kikifachrizi/Development_Food_Assistant_Robot/riset_base_3_revisi_update/rotaryencoder/README.md

# RotaryEncoder
Qudrature Rotary Encoder for DC Motor to measure position and speed in any STM32 Board with Mbed Frameworks. Works with mbed-os 5.
