kikifachrizi/Development_Food_Assistant_Robot/report_11_05_2024/Report T.I.F.A 06112024.pdf

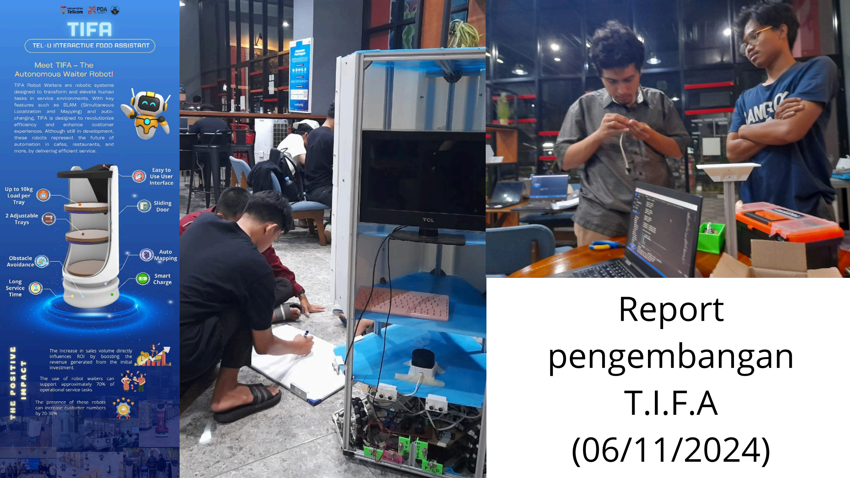
[picture p2: page 1]

## Report pengembangan T.I.F.A

(06/11/2024)

## Objective Pembahasan : 1.Proof of concept (done) 2.Proof of concept (process) 3.Result Progres 4.Program Matrikulasi Teknis

Update :
1.Robot System
Metode Kinematik and
Environment Learning

2.

3.Result proof of concept

Goal :
1.Obstacle Avoidance
2.Looks Robot
3.Lifetime robot
4.Mapping

Proof of Concept (done)
Serial communication
between Micro

1.

2.Mapping from Lidar
3.ERD database
4.Application interface

Proof of Concept (process) Printing Prototype robot
design 1:1 Scale

1.

Update Algorithm
Kinematics robot

2.

3.TF library & Kalman Filter robot baru mencapai 30% pengembangan berdasarkan semua metode yang sudah di coba (yang gagal dan berhasil)

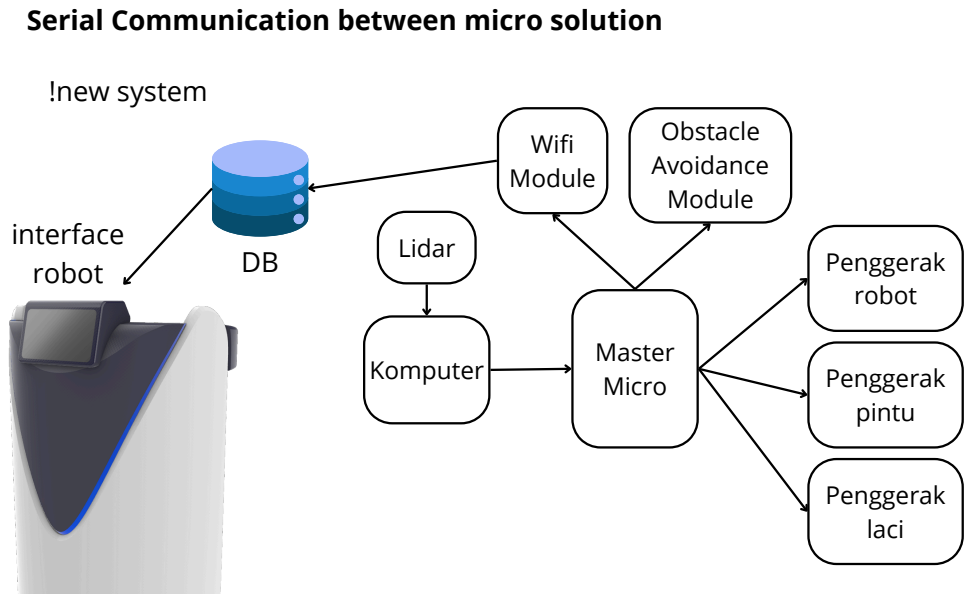
[picture p3: page 4]
Komputer; Master Micro; Lidar; Wifi Module; Obstacle Avoidance Module; Penggerak robot; Penggerak laci; Penggerak pintu; !new system; interface; robot

Serial Communication between micro solution

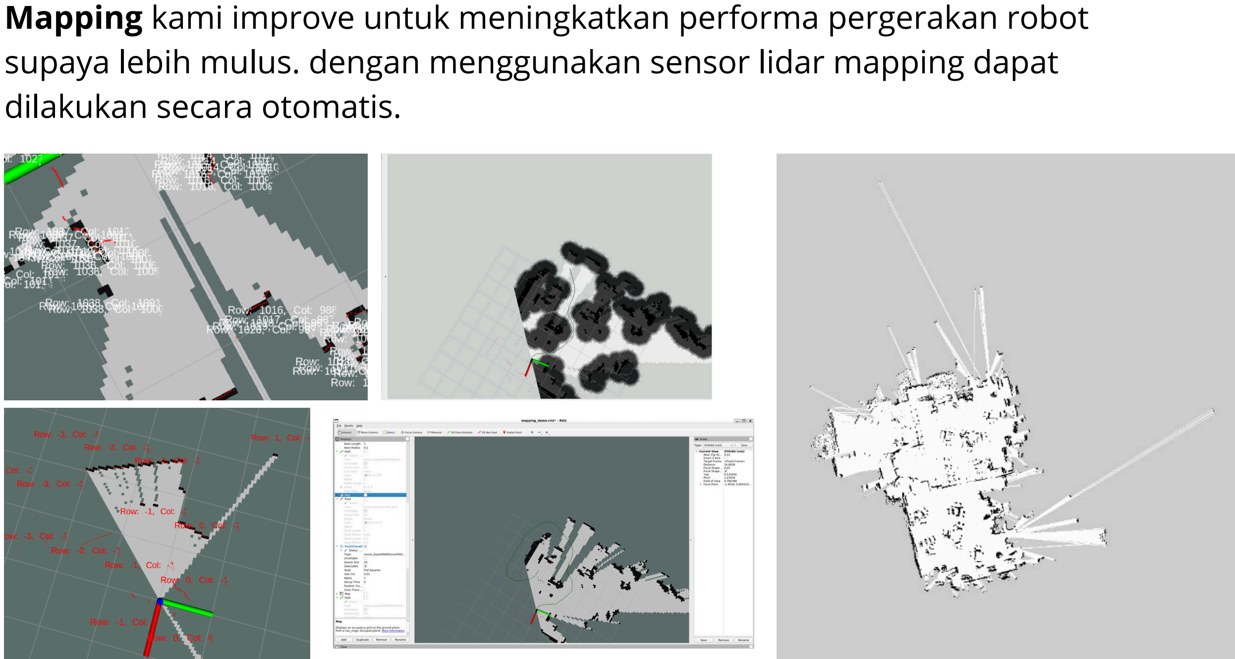
[picture p4: page 5]

Mapping kami improve untuk meningkatkan performa pergerakan robot supaya lebih mulus. dengan menggunakan sensor lidar mapping dapat dilakukan secara otomatis.

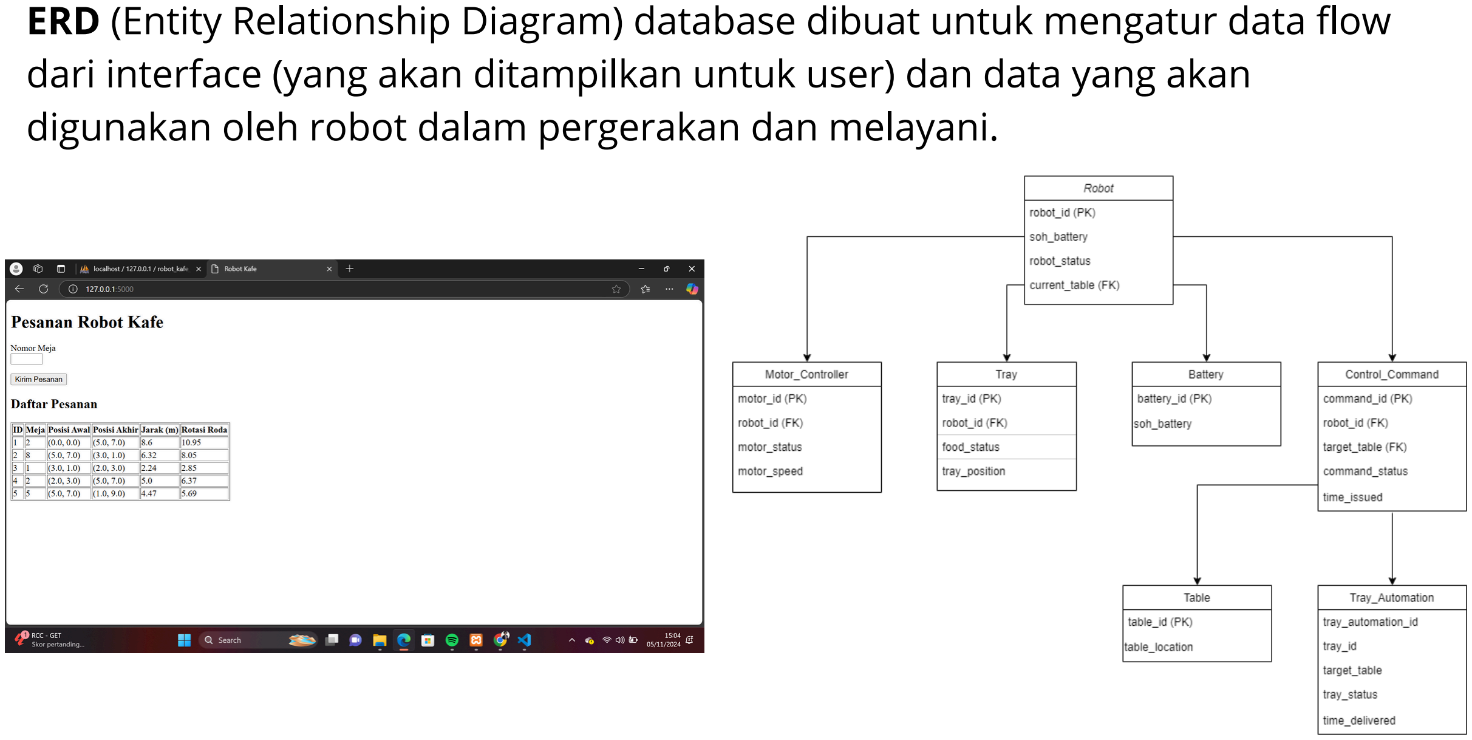
[picture p5: page 6]

ERD (Entity Relationship Diagram) database dibuat untuk mengatur data flow dari interface (yang akan ditampilkan untuk user) dan data yang akan digunakan oleh robot dalam pergerakan dan melayani.

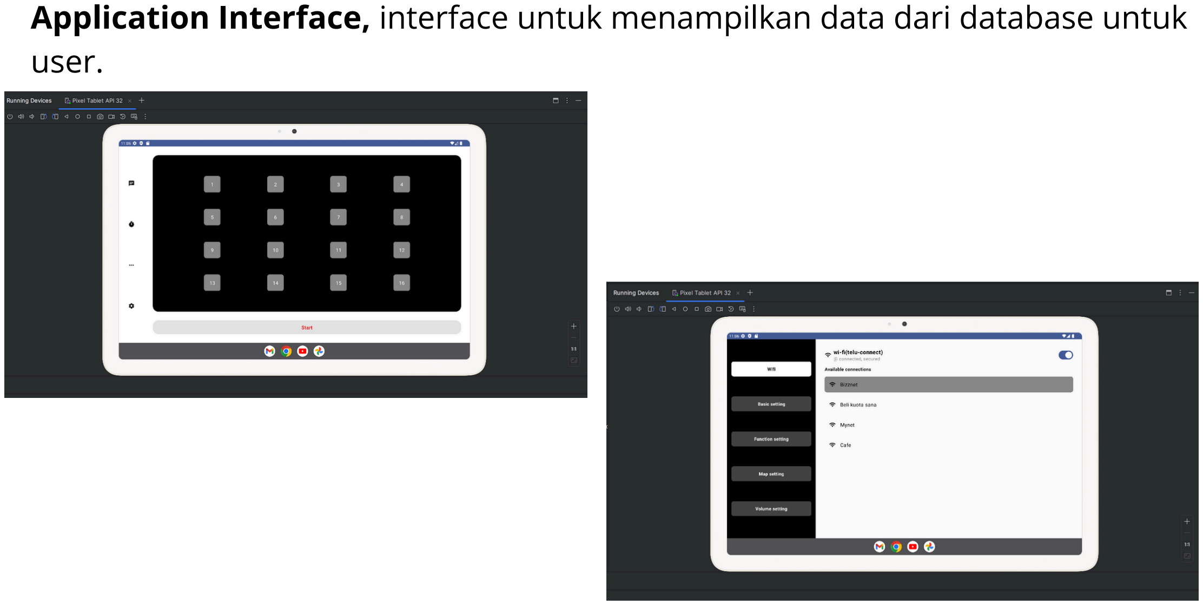
[picture p6: page 7]

Application Interface, interface untuk menampilkan data dari database untuk user.

Berikut beberapa proof of concept yang masih di tahap pengerjaan saat ini:

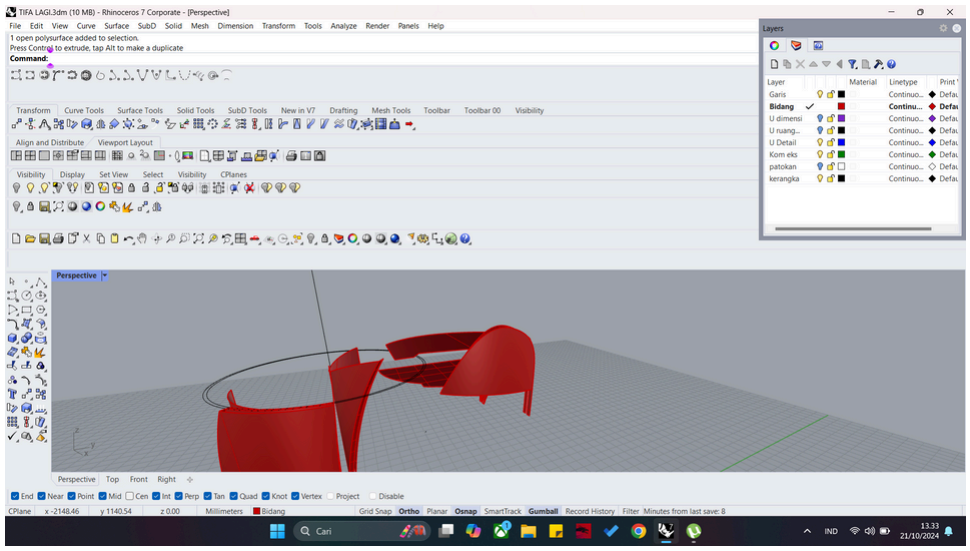
[picture p7: figure]
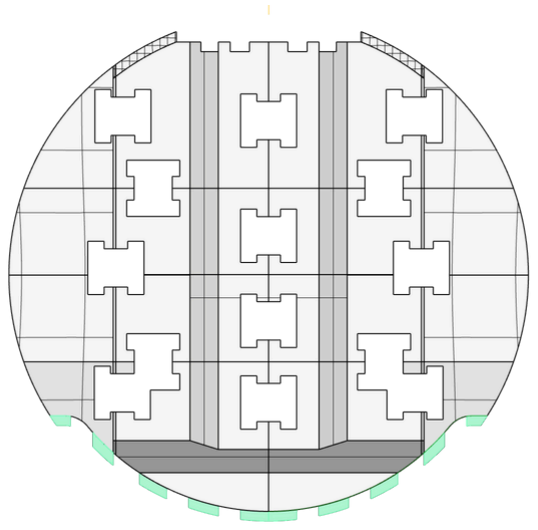
[picture p8: figure]
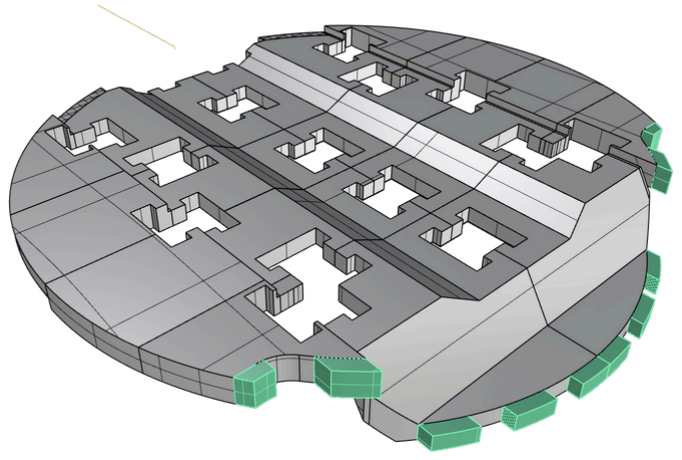
[picture p9: figure]

tahap ini kami membuat cetakan dengan mesin 3D print untuk manufaktur body robot, selain itu kami juga masih dalam tahap riset terkait kinematik dan filtering untuk motion robot.

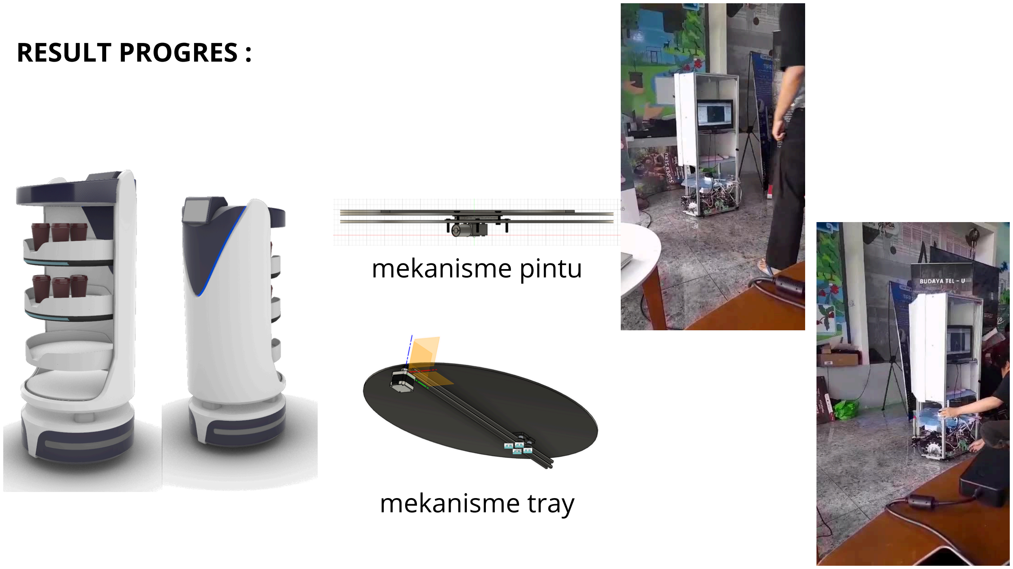
[picture p10: page 9]

RESULT PROGRES :

mekanisme pintu

mekanisme tray

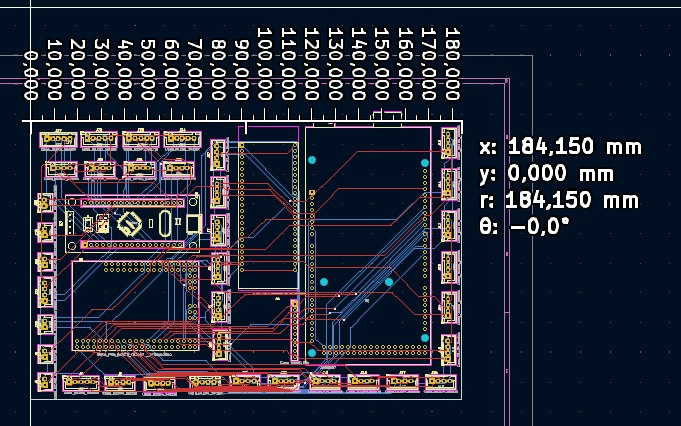
[picture p11: page 10]

Program Matrikulasi Teknis
Matrikulasi teknis kami berikan untuk pembekalan tim dalam pengerjaan robot, sehingga tim memiliki banyak waktu dalam melakukan riset hal baru. tim teknis tidak perlu melakukan riset yang sudah dilakukan karena semua itu akan di berikan di matrikulasi teknis oleh kami.

1.Kinematika dasar : robot 2 roda differential kinematik 2.Kontrol dasar : PID for mobile robot
3.Kinematika dan Kontrol

# List Sponsor

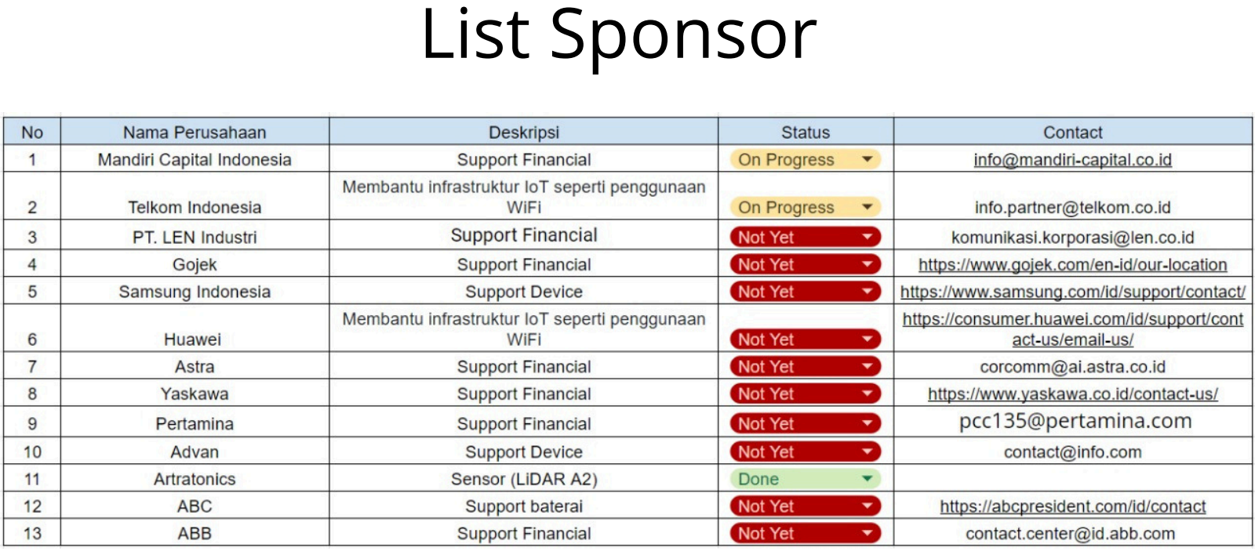
[picture p12: page 12]

# Terima Kasih🙏🙏🙏
