kikifachrizi/Development_Food_Assistant_Robot/documentation/IoT/RANGKUMAN SENSOR PROXIMITY SHARP A041SK.pdf

RANGKUMAN SENSOR PROXIMITY SHARP A041SK/GP2Y0A41SK0F
Berikut adalah perbandingan singkat dan jelas antara sensor Sharp GP2Y0A41SK dan load cell: Sensor Sharp GP2Y0A41SK

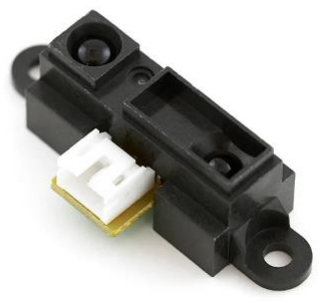
[picture p18: figure]
Kelebihan :

Sensitivitas Tinggi : Mendeteksi partikel debu kecil. Rata-rata digunakan untuk pemantauan kualitas udara, tapi bisa dipakai untuk mengukur jarak benda
Punya jarak yang bermacam macam sesuai kebutuhan
Gampang ditemuin : efisiensi tempat
Dari daya yang di lihat termasuk iot Daya Rendah : Hemat dan bisa digunakan jangka panjang alat berukuran kecil, mudah dipasang.

Sejauh aku liat risetnya :
- Pemantauan kualitas udara (paling banyak)
- Alat pembersih udara.
- Proyek IoT untuk lingkungan.
- IOT mengukur jarak benda

Beberapa video yang aku jadikan reference untuk sharp A041SK

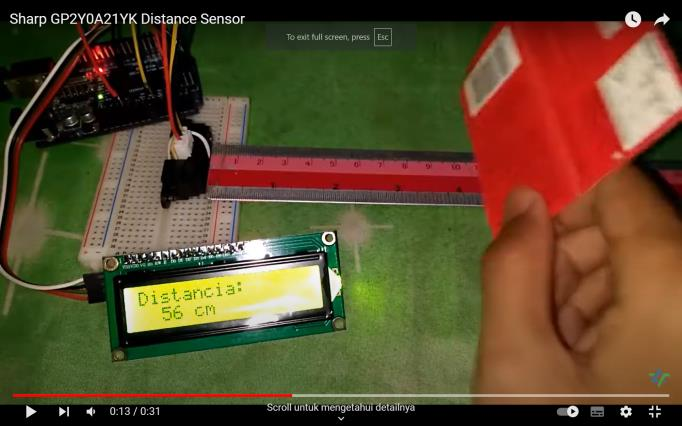
[picture p19: figure]
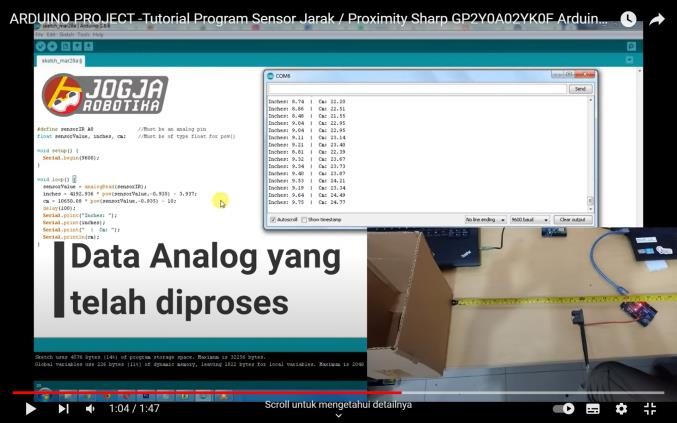
[picture p20: figure]
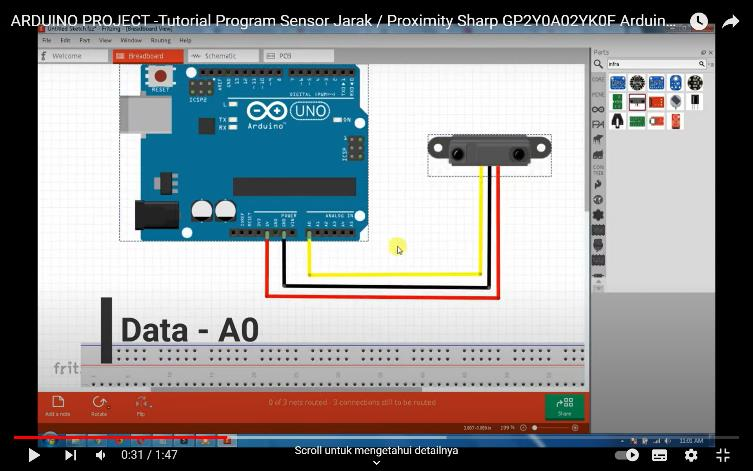
[picture p21: figure]
