kikifachrizi/Development_Food_Assistant_Robot/documentation/POWER/BMS Pemilihan Prototype.pdf

## BMS DESIGN

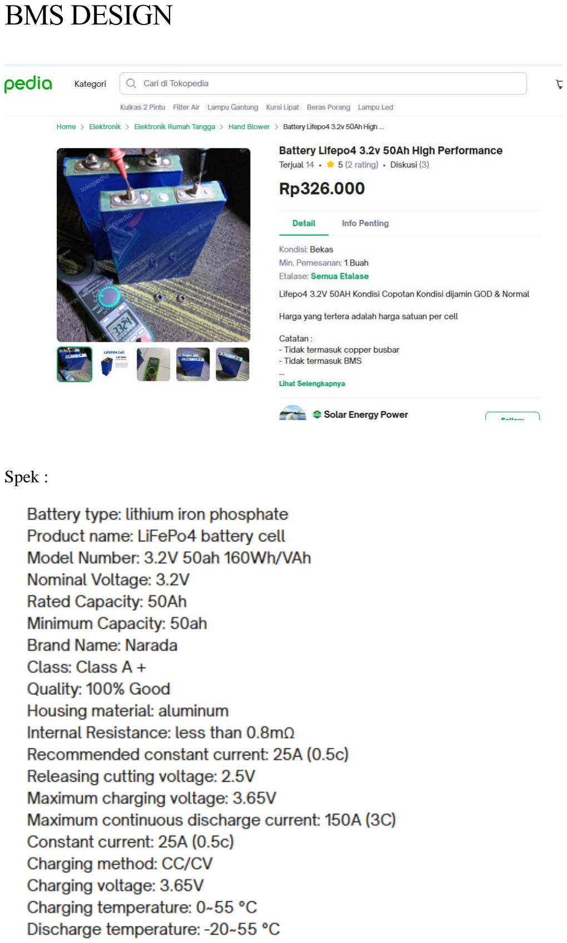
[picture p22: page 1]

Spek :

Jika Ingin 12 Jam Backup

BMS 4s = 12.8 V/50 ah = 640 Wh , Beban Max = 53 W

BMS 8s = 25.6 V/50 ah = 1,280 Wh, Beban Max = 106 W

BMS 16s = 51.2 V/50 ah = 2,560 Wh, Beban Max = 213 W

BMS Current = 25 A

BMS Prototype 2 Opsi :

1.Pakai IC Khusus BMS

IC dari Texas Instrument

IC BQ76952

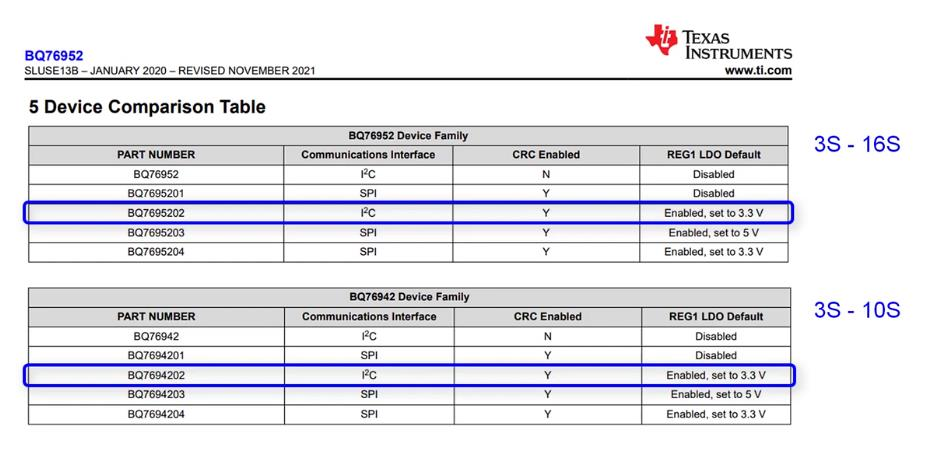
[picture p23: figure]

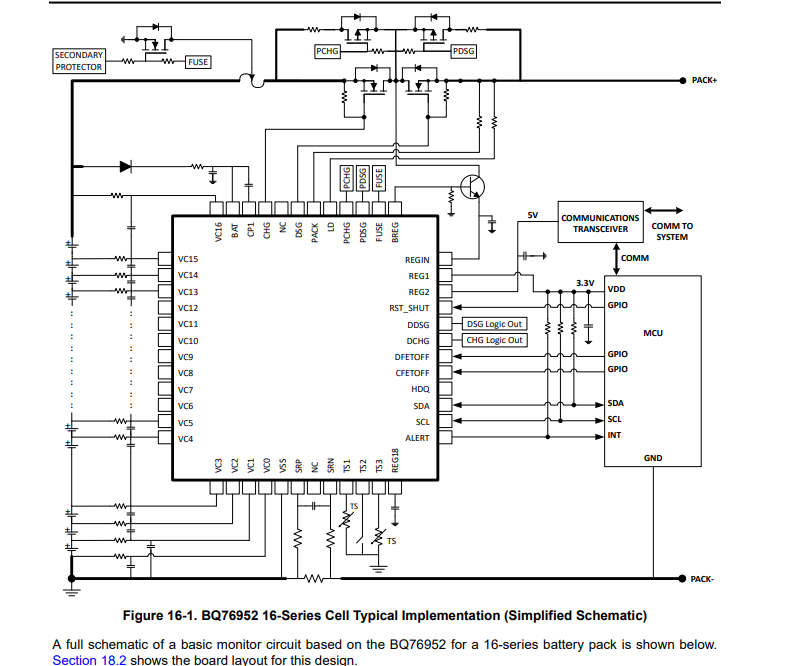
[picture p24: figure]

Pros:

-Up to 16S

-Dokumentasi Hardware dan Software Lengkap langsung dari official

Cons :

-IC dan Komponen pendukung lainnya relative sulit di jual belikan di Indonesia

2.Tidak Pakai IC

Contoh 7s

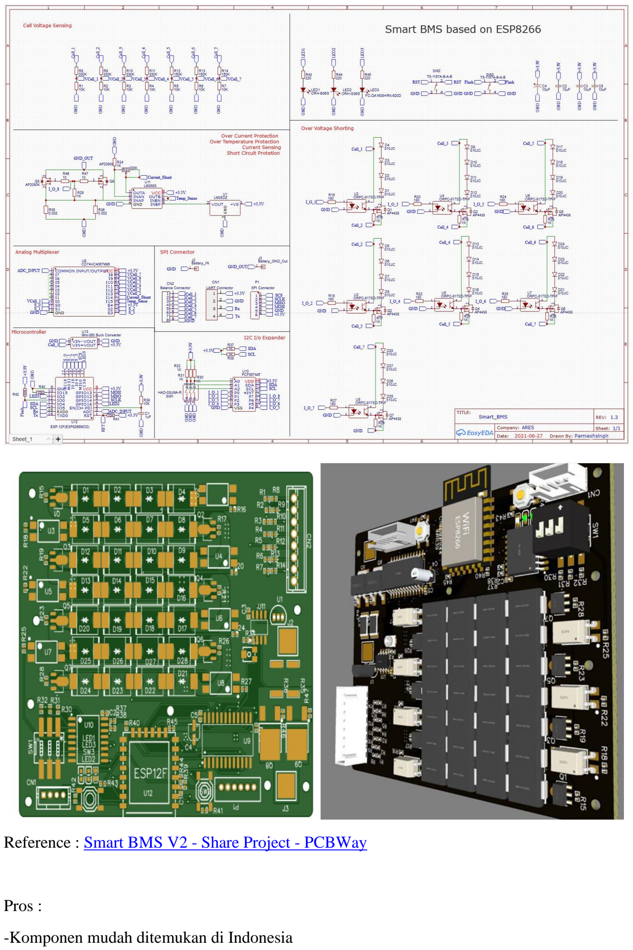
[picture p25: page 4]

Reference : Smart BMS V2 - Share Project - PCBWay (https://www.pcbway.com/project/shareproject/Smart_BMS_V2.html)

Pros :

-Komponen mudah ditemukan di Indonesia

Cons :

-Dokumentasi tidak Lengkap, perlu di pelajari lebih lanjut bagian software
