kikifachrizi/Development_Food_Assistant_Robot/documentation/POWER/Laporan Riset Awal Deli-Robot.pdf

### LAPORAN RISET DELI ROBOT TANGGAL : 06/09/2024

JENIS ROBOT YANG SUDAH ADA DAN POWER SYSTEM NYA

1. SIFROBOT

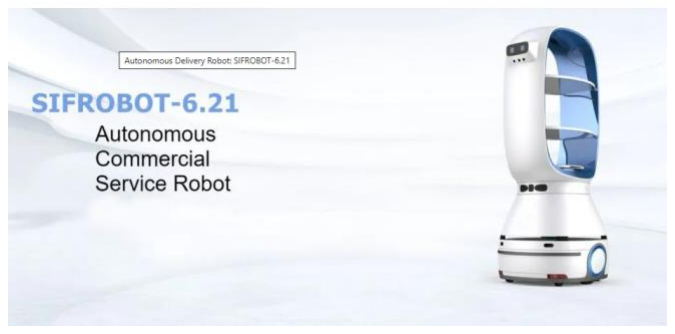
[picture p26: figure]

Di desain untuk kondisi COIVD-19, robot Indoor

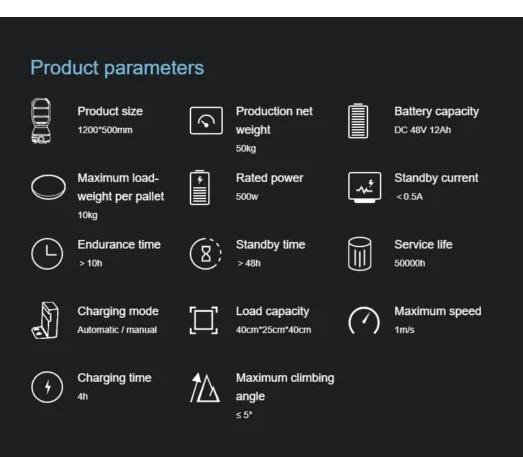
[picture p27: figure]

Spesifikasi utama :

Batterai Capacity : 48V/12 Ah

Arus StandBy : <0.5 A

Temp : 0 – 45 C

Daya :500 W

Durasi Battery : > 8 Jam

Referensi : Autonomous Delivery Robot: SIFROBOT-6.21 - SIFSOF (https://sifsof.com/product/autonomous-delivery-robot-sifrobot-6-21/)

2. DDY-4

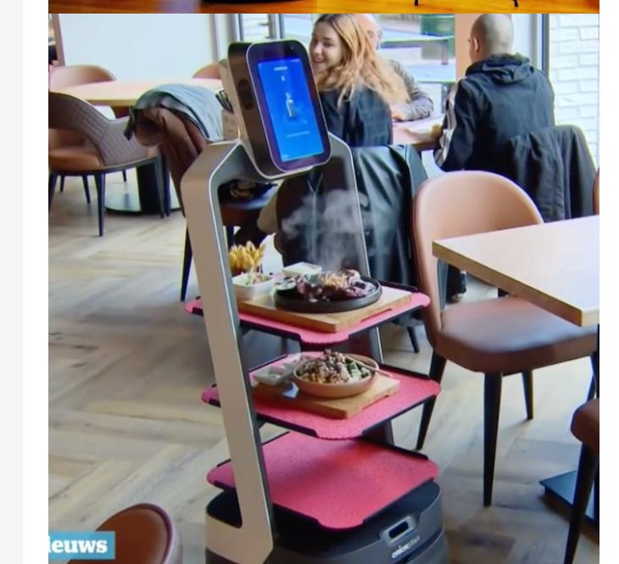
[picture p28: figure]

Spesifikasi utama :

Batterai Capacity : 48V/15 Ah

Arus StandBy : <0.5 A

Temp : 0 – 45 C

Daya :30 W

Durasi Battery : > 8 Jam

Referensi : Pelayan White Delivery Robot Food 12-14H Battery Life Steak Sushi Restaurant (services-robot.com) (https://indonesian.services-robot.com/sale-14495258-waiters-white-delivery-robot-food-12-14h-battery-life-steak-sushi-restaurant.html)

3. REEMAN – DELIGO

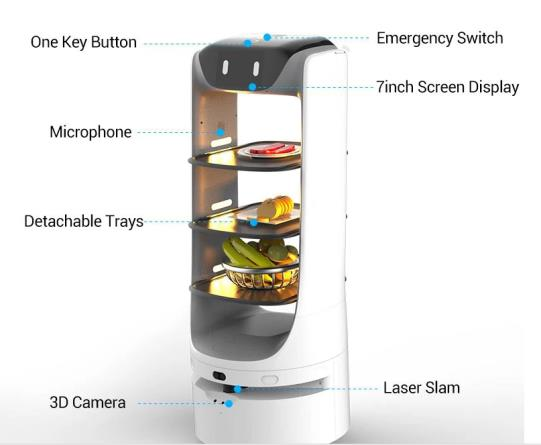
[picture p29: figure]

Spesifikasi utama :

Batterai Capacity : 24V/20 Ah

Temp : 0 – 45 C

Durasi Battery : 10-12 Jam

Referensi : Cina Disesuaikan Reeman Robot Pelayan Restoran Cepat Saji Pengiriman Robot Layanan Robot Pemasok, Produsen - Pabrik Grosir Langsung - REEMAN (https://id.reemanrobot.com/delivery-robot/restaurant-delivery-robot-service.html)

4.
Note : Tidak dapat ditemukan Detail dari jenis Battery yang digunakan, namun rata rata battery yang digunakan adalah Lithium

PERBEDAAN NMC DAN LIFEPO4, SERTA KEUNGGULANNYA

1. KOMPOSISI MATERIAL
NMC Menggunakan Nickel Manganese Cobalt Oxide LFP Menggunakan Lithium Ferrous Phosphate
2. ENERGY DENSITY
NMC = 150-200 Wh/KG
LFP = 100-150 Wh/KG
NMC Memiliki Kepadatan Energi yang lebih tinggi
3. CYCLE
NMC = 2000-2500
LFP = 5000
LFP Lebih tahan lama, memiliki 2x lipat Cycle dari NMC
4. SAFETY
NMC = Material Stabil, Namun komposisi dari material dapat menyebabkan Peledakan ataupun kebakaran jika terjadi kesalahan (Note : Material menghasilkan pelepasan Oksigen)

LFP = Material Stabil dan Dapat mengatasi Temperature yang tinggi(Note : Tidak menhasilkan Oksigen)

5. POWER
NMC = 3.7 V
LFP = 3.2 V

Referensi : Lithium NMC vs LiFePO4 - How to Choose the Best One for Your Needs (ecotreelithium.co.uk) (https://ecotreelithium.co.uk/news/lithium-nmc-vs-lifepo4/)

Kesimpulan , menurut saya sebagai kebutuhan power dari Deli-Robot, LFP atau LIFEPO4 lebih cocok digunakan. Mempertimbangkan safety dan daya tahan karena lebih baik. Untuk power yang lebih rendah kita dapat memodifikasi walaupun artinya menjadi lebih mahal, namun menurut saya Value nya sebanding dengan fitur yang ditawarkan.
