kikifachrizi/Development_Food_Assistant_Robot/documentation/POWER/PROGRESS DESAIN PCB.pdf

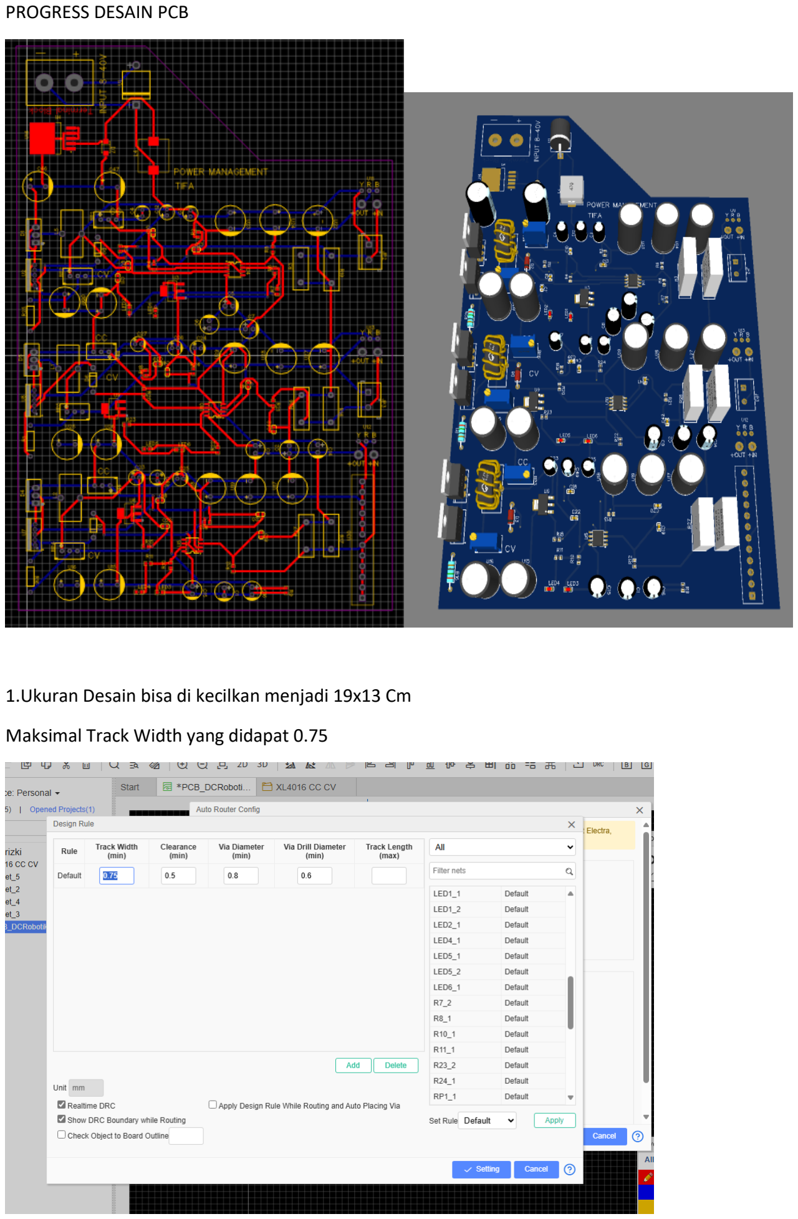
[picture p30: page 1]

PROGRESS DESAIN PCB

1.Ukuran Desain bisa di kecilkan menjadi 19x13 Cm

Maksimal Track Width yang didapat 0.75

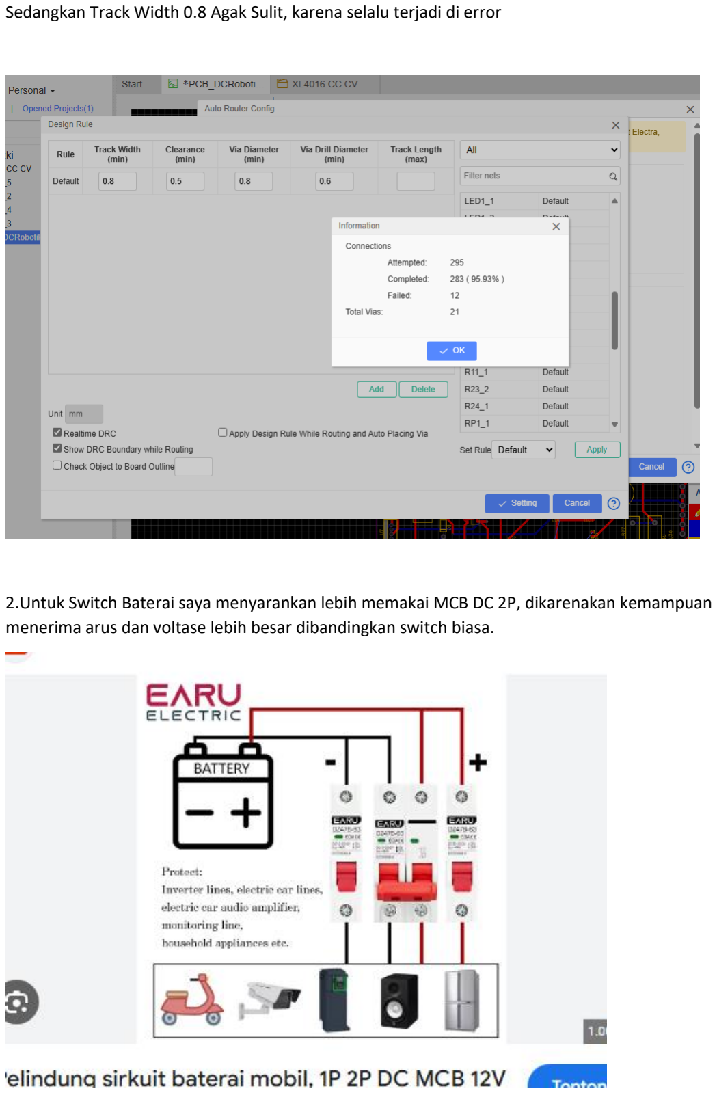
[picture p31: page 2]

Sedangkan Track Width 0.8 Agak Sulit, karena selalu terjadi di error

2.Untuk Switch Baterai saya menyarankan lebih memakai MCB DC 2P, dikarenakan kemampuan menerima arus dan voltase lebih besar dibandingkan switch biasa.

3.Masih belajar Routing menggunakan Altium karena terdapat interactive routing.Jika di easyeda routing masih terlihat berantakan dapat menimbulkan noise karena desain cenderung kompleks.
