kikifachrizi/Development_Food_Assistant_Robot/documentation/POWER/BMS Spec.xlsx

Sheet: Sheet1
 |  | Beban BMS
Nama | Ampere | Voltage |  | Nama | Ampere | Voltage
Raspi 5 | 3 | 5 |  | Raspi 5 | 3 | 5
Motor PG28 (4 buah) | 0.16 | 24 |  | Motor PG28 (4 buah) | 0.16 | 24
Motor PG45 (4 buah) | 3.2 | 24 |  | Motor PG45 (4 buah) | 0 | 24
Linear actuator | 0 | 12 |  | Linear actuator | 0 | 12
Arduino mega pro | 0.8 | 5 |  | Arduino mega pro | 0.8 | 5
STM32 | 0 | 2 |  | STM32 | 0 | 2
ESP | 0.0238 | 3.2 V |  | ESP | 0.0238 | 3.2 V
MPU6050 | 0.0036 | 2.375V-3.46V |  | MPU6050 | 0.0036 | 2.375V-3.46V
4 motor driver l298N | 0.05 | 5-35 V |  | 4 motor driver l298N | 0.05 | 5-35 V
Lidar | 0.5 | 12 |  | Lidar | 0.5 | 12
ultrasonic (16 buah) | 0.1 | 5 |  | ultrasonic (16 buah) | 0.1 | 5
Total | 7.8374 |  |  | Total | 4.6374
 | Amper | Voltage | W
 | 7.8374 | 24 | 188.0976
 | 4.6374 | 24 | 111.2976
 | 7.8374 | 36 | 282.1464 |  |  |  |  | Ubah Watt
 | 4.6374 | 36 | 166.9464 | Backup Batt |  | Voltage | Ampere | Watt | Berat Gram
 | 7.8374 | 48 | 376.1952 |  |  | 3.7 | 5 | 111.2976 | 71
 | 4.6374 | 48 | 222.5952 | Seri | Pararel | Voltage | A | Watt | Durasi(Jam) | Berat Batt
 | Note : Hasil Beban Daya Voltage Dapat diubah |  |  | 10 | 4 | 37 | 20 | 740 | 6.648840586 | 2840
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
