kikifachrizi/Development_Food_Assistant_Robot/Documentation/Images/design.jpeg

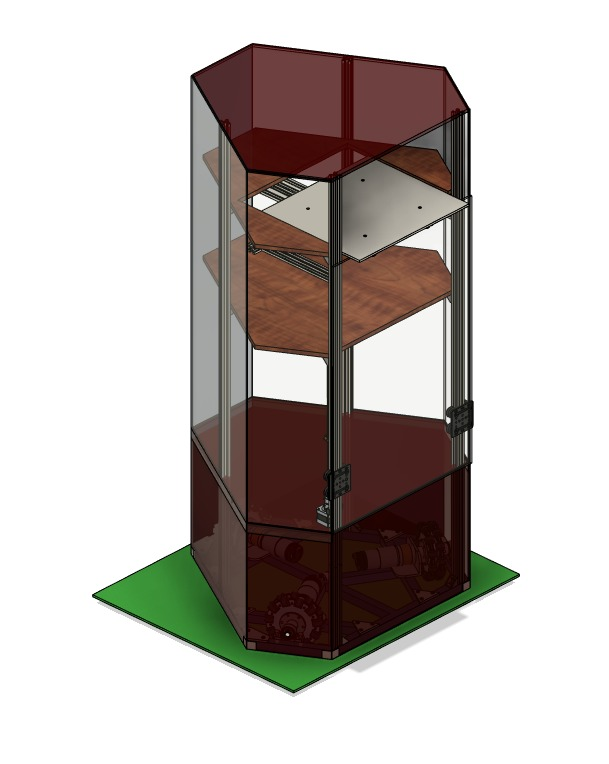
Documentation/Images/design.jpeg
