kikifachrizi/Development_Food_Assistant_Robot/Documentation/Images/design_2.jpeg

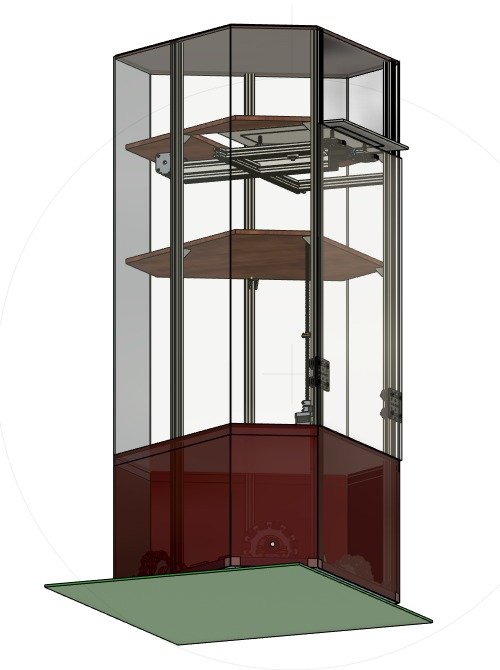
Documentation/Images/design_2.jpeg
