kikifachrizi/Development_Food_Assistant_Robot/Documentation/Images/design_3.jpeg

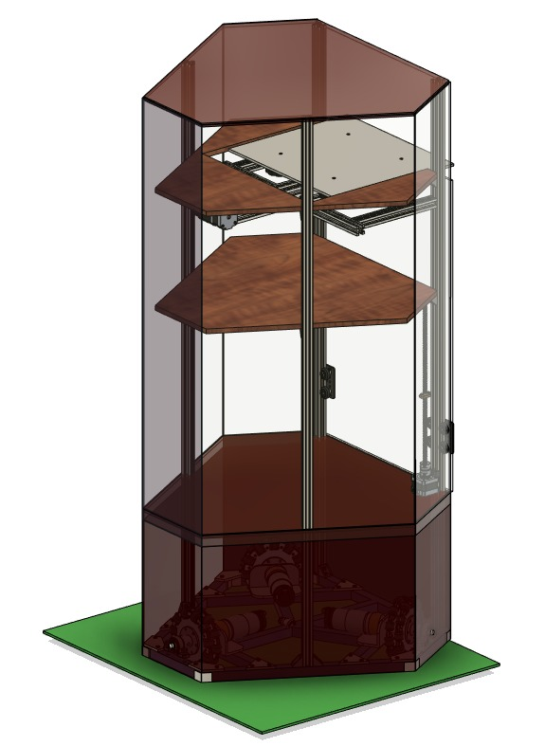
Documentation/Images/design_3.jpeg
