kikifachrizi/Development_Food_Assistant_Robot/Documentation/Images/ext_enc_prototype_v1.jpeg

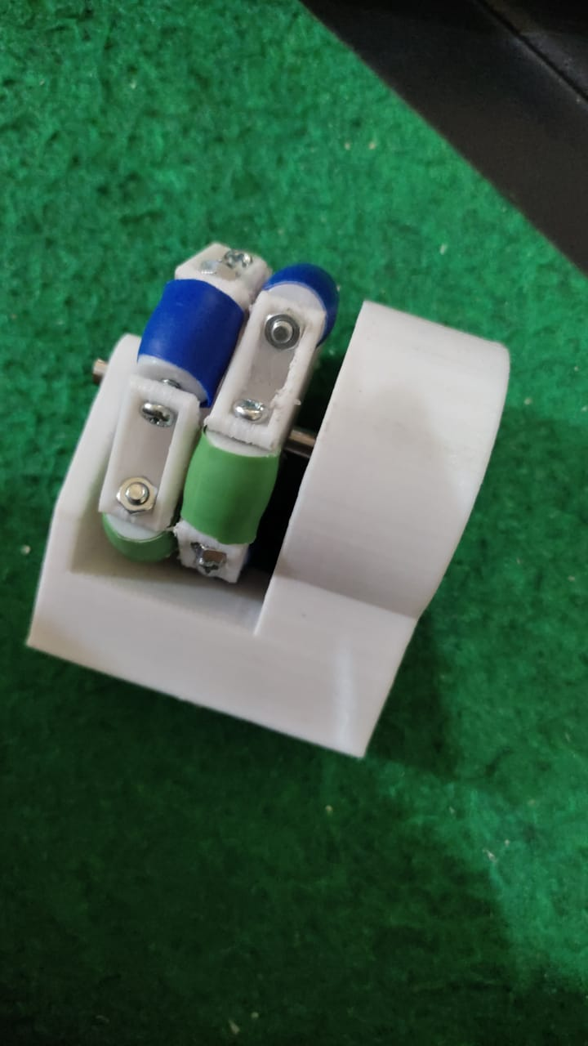
Documentation/Images/ext_enc_prototype_v1.jpeg
