kikifachrizi/Development_Food_Assistant_Robot/Documentation/Images/prototype.jpeg

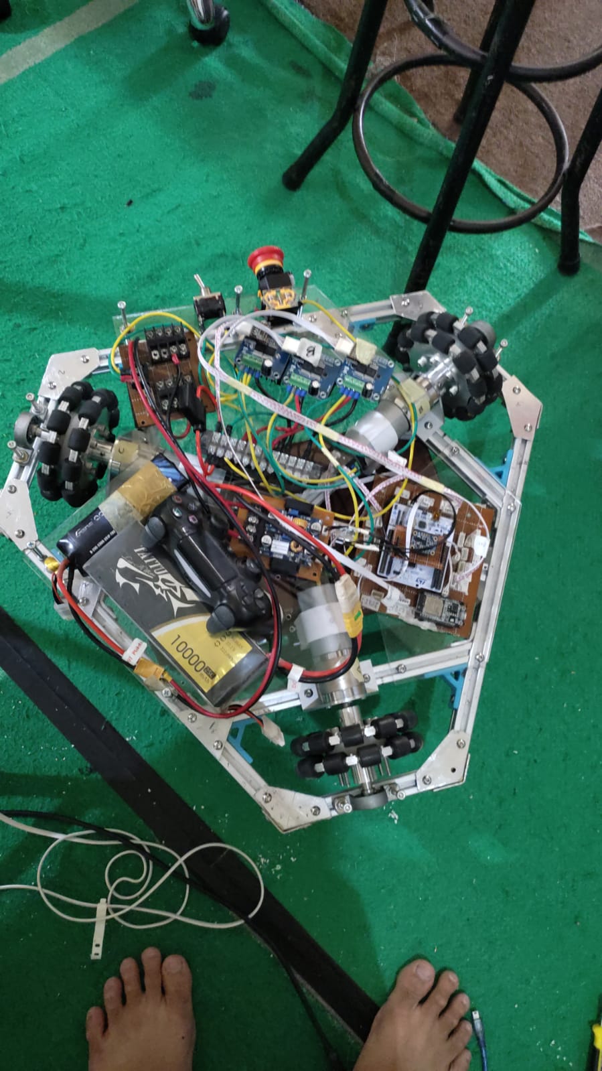
Documentation/Images/prototype.jpeg
