kikifachrizi/Development_Food_Assistant_Robot/documentation/POWER/Komponen List.xlsx

ID | NAME | DESIGN | _x0000_Q_x0000_u_x0000_a_x0000_n_x0000_t_x0000_i_x0000_t_x0000_y_x0000_
_x0000__x0000_1_x0000__x0000_ | _x0000__x0000_P_x0000_-_x0000_1_x0000_2_x0000__x0000_ | _x0000__x0000_U_x0000_3_x0000_0_x0000__x0000_ | _x0000__x0000_1_x0000__x0000_
_x0000__x0000_2_x0000__x0000_ | _x0000__x0000_4_x0000_7_x0000_u_x0000_F_x0000__x0000_ | _x0000__x0000_C_x0000_1_x0000_,_x0000_C_x0000_2_x0000_,_x0000_C_x0000_5_x0000_,_x0000_C_x0000_6_x0000_,_x0000_C_x0000_7_x0000_,_x0000_C_x0000_9_x0000_,_x0000_C_x0000_1_x0000_4_x0000_,_x0000_C_x0000_1_x0000_5_x0000_,_x0000_C_x0000_1_x0000_6_x0000__x0000_ | _x0000__x0000_9_x0000__x0000_
_x0000__x0000_3_x0000__x0000_ | _x0000__x0000_1_x0000_u_x0000_F_x0000__x0000_ | _x0000__x0000_C_x0000_3_x0000_,_x0000_C_x0000_4_x0000_,_x0000_C_x0000_1_x0000_2_x0000_,_x0000_C_x0000_2_x0000_3_x0000_,_x0000_C_x0000_2_x0000_4_x0000_,_x0000_C_x0000_2_x0000_5_x0000_,_x0000_C_x0000_2_x0000_6_x0000_,_x0000_C_x0000_2_x0000_7_x0000_,_x0000_C_x0000_4_x0000_9_x0000__x0000_ | _x0000__x0000_9_x0000__x0000_
_x0000__x0000_4_x0000__x0000_ | _x0000__x0000_3_x0000_3_x0000_n_x0000_F_x0000__x0000_ | _x0000__x0000_C_x0000_8_x0000_,_x0000_C_x0000_2_x0000_2_x0000_,_x0000_C_x0000_3_x0000_9_x0000__x0000_ | _x0000__x0000_3_x0000__x0000_
_x0000__x0000_5_x0000__x0000_ | _x0000__x0000_1_x0000_0_x0000_n_x0000_F_x0000__x0000_ | _x0000__x0000_C_x0000_1_x0000_0_x0000_,_x0000_C_x0000_2_x0000_0_x0000_,_x0000_C_x0000_4_x0000_1_x0000__x0000_ | _x0000__x0000_3_x0000__x0000_
_x0000__x0000_6_x0000__x0000_ | _x0000__x0000_1_x0000_0_x0000_0_x0000_n_x0000_F_x0000__x0000_ | _x0000__x0000_C_x0000_1_x0000_1_x0000_,_x0000_C_x0000_1_x0000_3_x0000_,_x0000_C_x0000_1_x0000_8_x0000_,_x0000_C_x0000_1_x0000_9_x0000_,_x0000_C_x0000_4_x0000_2_x0000_,_x0000_C_x0000_4_x0000_3_x0000__x0000_ | _x0000__x0000_6_x0000__x0000_
_x0000__x0000_7_x0000__x0000_ | _x0000__x0000_6_x0000_8_x0000_0_x0000_u_x0000_F_x0000__x0000_ | _x0000__x0000_C_x0000_4_x0000_6_x0000__x0000_ | _x0000__x0000_1_x0000__x0000_
_x0000__x0000_8_x0000__x0000_ | _x0000__x0000_2_x0000_2_x0000_0_x0000_u_x0000_F_x0000__x0000_ | _x0000__x0000_C_x0000_4_x0000_7_x0000__x0000_ | _x0000__x0000_1_x0000__x0000_
_x0000__x0000_9_x0000__x0000_ | _x0000__x0000_M_x0000_B_x0000_R_x0000_2_x0000_0_x0000_1_x0000_0_x0000_0_x0000_C_x0000_T_x0000__x0000_ | _x0000__x0000_D_x0000_1_x0000_,_x0000_D_x0000_4_x0000_,_x0000_D_x0000_5_x0000__x0000_ | _x0000__x0000_3_x0000__x0000_
_x0000__x0000_1_x0000_0_x0000__x0000_ | _x0000__x0000_1_x0000_N_x0000_4_x0000_1_x0000_4_x0000_8_x0000__x0000_ | _x0000__x0000_D_x0000_2_x0000_,_x0000_D_x0000_3_x0000_,_x0000_D_x0000_6_x0000__x0000_ | _x0000__x0000_3_x0000__x0000_
_x0000__x0000_1_x0000_1_x0000__x0000_ | _x0000__x0000_S_x0000_S_x0000_5_x0000_4_x0000_F_x0000__x0000_ | _x0000__x0000_D_x0000_7_x0000__x0000_ | _x0000__x0000_1_x0000__x0000_
_x0000__x0000_1_x0000_2_x0000__x0000_ | _x0000__x0000_1_x0000_0_x0000_m_x0000_m_x0000_ _x0000_t_x0000_e_x0000_r_x0000_m_x0000_i_x0000_n_x0000_a_x0000_l_x0000_ _x0000_b_x0000_l_x0000_o_x0000_c_x0000_k_x0000__x0000_ | _x0000__x0000_H_x0000_1_x0000__x0000_ | _x0000__x0000_1_x0000__x0000_
_x0000__x0000_1_x0000_3_x0000__x0000_ | _x0000__x0000_M_x0000_0_x0000_2_x0000__x0000_ | _x0000__x0000_J_x0000_P_x0000_2_x0000_,_x0000_J_x0000_P_x0000_3_x0000__x0000_ | _x0000__x0000_2_x0000__x0000_
_x0000__x0000_1_x0000_4_x0000__x0000_ | _x0000__x0000_4_x0000_7_x0000_U_x0000_H_x0000_/_x0000_1_x0000_0_x0000_A_x0000__x0000_ | _x0000__x0000_L_x0000_1_x0000_,_x0000_L_x0000_2_x0000_,_x0000_L_x0000_5_x0000__x0000_ | _x0000__x0000_3_x0000__x0000_
_x0000__x0000_1_x0000_5_x0000__x0000_ | _x0000__x0000_3_x0000_3_x0000_u_x0000_H_x0000__x0000_ | _x0000__x0000_L_x0000_4_x0000__x0000_ | _x0000__x0000_1_x0000__x0000_
_x0000__x0000_1_x0000_6_x0000__x0000_ | _x0000__x0000_L_x0000_E_x0000_D_x0000_-_x0000_0_x0000_6_x0000_0_x0000_3_x0000___x0000_R_x0000__x0000_ | _x0000__x0000_L_x0000_E_x0000_D_x0000_1_x0000_,_x0000_L_x0000_E_x0000_D_x0000_2_x0000_,_x0000_L_x0000_E_x0000_D_x0000_3_x0000_,_x0000_L_x0000_E_x0000_D_x0000_4_x0000_,_x0000_L_x0000_E_x0000_D_x0000_5_x0000_,_x0000_L_x0000_E_x0000_D_x0000_6_x0000__x0000_ | _x0000__x0000_6_x0000__x0000_
_x0000__x0000_1_x0000_7_x0000__x0000_ | 0 Ohm | _x0000__x0000_R_x0000_1_x0000_,_x0000_R_x0000_1_x0000_6_x0000_,_x0000_R_x0000_2_x0000_5_x0000__x0000_ | _x0000__x0000_3_x0000__x0000_
_x0000__x0000_1_x0000_8_x0000__x0000_ | _x0000__x0000_6_x0000_8_x0000_0_x0000_R_x0000__x0000_ | _x0000__x0000_R_x0000_2_x0000_,_x0000_R_x0000_4_x0000_,_x0000_R_x0000_1_x0000_3_x0000_,_x0000_R_x0000_1_x0000_5_x0000_,_x0000_R_x0000_1_x0000_8_x0000_,_x0000_R_x0000_2_x0000_0_x0000__x0000_ | _x0000__x0000_6_x0000__x0000_
_x0000__x0000_1_x0000_9_x0000__x0000_ | _x0000__x0000_1_x0000_0_x0000_R_x0000__x0000_ | _x0000__x0000_R_x0000_5_x0000_,_x0000_R_x0000_8_x0000_,_x0000_R_x0000_9_x0000_,_x0000_R_x0000_1_x0000_2_x0000_,_x0000_R_x0000_2_x0000_1_x0000_,_x0000_R_x0000_2_x0000_4_x0000__x0000_ | _x0000__x0000_6_x0000__x0000_
_x0000__x0000_2_x0000_0_x0000__x0000_ | _x0000__x0000_4_x0000_7_x0000_0_x0000_R_x0000__x0000_ | _x0000__x0000_R_x0000_6_x0000_,_x0000_R_x0000_7_x0000_,_x0000_R_x0000_1_x0000_0_x0000_,_x0000_R_x0000_1_x0000_1_x0000_,_x0000_R_x0000_2_x0000_2_x0000_,_x0000_R_x0000_2_x0000_3_x0000__x0000_ | _x0000__x0000_6_x0000__x0000_
_x0000__x0000_2_x0000_1_x0000__x0000_ | Potentio | _x0000__x0000_R_x0000_3_x0000_,_x0000_R_x0000_1_x0000_4_x0000_,_x0000_R_x0000_1_x0000_7_x0000_,_x0000_R_x0000_1_x0000_9_x0000_,_x0000_R_x0000_2_x0000_6_x0000_,_x0000_R_x0000_2_x0000_7_x0000__x0000_ | _x0000__x0000_6_x0000__x0000_
_x0000__x0000_2_x0000_2_x0000__x0000_ | _x0000__x0000_R_x0000___x0000_3_x0000_2_x0000_9_x0000_6_x0000_W_x0000___x0000_U_x0000_S_x0000__x0000_ | _x0000__x0000_R_x0000_P_x0000_1_x0000_,_x0000_R_x0000_P_x0000_2_x0000_,_x0000_R_x0000_P_x0000_3_x0000_,_x0000_R_x0000_P_x0000_4_x0000_,_x0000_R_x0000_P_x0000_5_x0000_,_x0000_R_x0000_P_x0000_6_x0000__x0000_ | _x0000__x0000_6_x0000__x0000_
_x0000__x0000_2_x0000_3_x0000__x0000_ | _x0000__x0000_2_x0000_0_x0000_A_x0000_1_x0000_0_x0000_ _x0000_T_x0000_B_x0000__x0000_ | _x0000__x0000_U_x0000_1_x0000__x0000_ | _x0000__x0000_1_x0000__x0000_
_x0000__x0000_2_x0000_4_x0000__x0000_ | _x0000__x0000_X_x0000_L_x0000_4_x0000_0_x0000_1_x0000_6_x0000_E_x0000_1_x0000__x0000_ | _x0000__x0000_U_x0000_2_x0000_,_x0000_U_x0000_7_x0000_,_x0000_U_x0000_8_x0000__x0000_ | _x0000__x0000_3_x0000__x0000_
_x0000__x0000_2_x0000_5_x0000__x0000_ | _x0000__x0000_T_x0000_S_x0000_4_x0000_2_x0000_6_x0000_4_x0000_C_x0000_W_x0000_5_x0000_0_x0000_ _x0000_R_x0000_P_x0000_G_x0000__x0000_ | _x0000__x0000_U_x0000_3_x0000_,_x0000_U_x0000_6_x0000_,_x0000_U_x0000_9_x0000__x0000_ | _x0000__x0000_3_x0000__x0000_
_x0000__x0000_2_x0000_6_x0000__x0000_ | _x0000__x0000_T_x0000_P_x0000_M_x0000_C_x0000_P_x0000_6_x0000_0_x0000_0_x0000_2_x0000_T_x0000_-_x0000_I_x0000_/_x0000_S_x0000_N_x0000__x0000_ | _x0000__x0000_U_x0000_4_x0000_,_x0000_U_x0000_5_x0000_,_x0000_U_x0000_1_x0000_0_x0000__x0000_ | _x0000__x0000_3_x0000__x0000_
_x0000__x0000_2_x0000_7_x0000__x0000_ | _x0000__x0000_D_x0000_S_x0000_N_x0000_-_x0000_V_x0000_C_x0000_2_x0000_8_x0000_8_x0000__x0000_ | _x0000__x0000_U_x0000_1_x0000_1_x0000_,_x0000_U_x0000_1_x0000_2_x0000_,_x0000_U_x0000_1_x0000_3_x0000__x0000_ | _x0000__x0000_3_x0000__x0000_
_x0000__x0000_2_x0000_8_x0000__x0000_ | _x0000__x0000_L_x0000_M_x0000_2_x0000_5_x0000_9_x0000_6_x0000_S_x0000_-_x0000_5_x0000_._x0000_0_x0000_N_x0000_O_x0000_P_x0000_B_x0000__x0000_ | _x0000__x0000_U_x0000_1_x0000_4_x0000__x0000_ | _x0000__x0000_1_x0000__x0000_
_x0000__x0000_2_x0000_9_x0000__x0000_ | _x0000__x0000_4_x0000_7_x0000_0_x0000_U_x0000_F_x0000_/_x0000_5_x0000_0_x0000_V_x0000_-_x0000_C_x0000_E_x0000_1_x0000_B_x0000__x0000_ | _x0000__x0000_U_x0000_1_x0000_5_x0000_,_x0000_U_x0000_1_x0000_6_x0000_,_x0000_U_x0000_1_x0000_7_x0000_,_x0000_U_x0000_1_x0000_8_x0000_,_x0000_U_x0000_1_x0000_9_x0000_,_x0000_U_x0000_2_x0000_0_x0000_,_x0000_U_x0000_2_x0000_1_x0000_,_x0000_U_x0000_2_x0000_2_x0000_,_x0000_U_x0000_2_x0000_3_x0000_,_x0000_U_x0000_2_x0000_4_x0000_,_x0000_U_x0000_2_x0000_5_x0000_,_x0000_U_x0000_2_x0000_6_x0000_,_x0000_U_x0000_2_x0000_7_x0000_,_x0000_U_x0000_2_x0000_8_x0000_,_x0000_U_x0000_2_x0000_9_x0000__x0000_ | _x0000__x0000_1_x0000_5_x0000__x0000_
_x0000_
