kikifachrizi/Development_Food_Assistant_Robot/prototype/base v5.stl

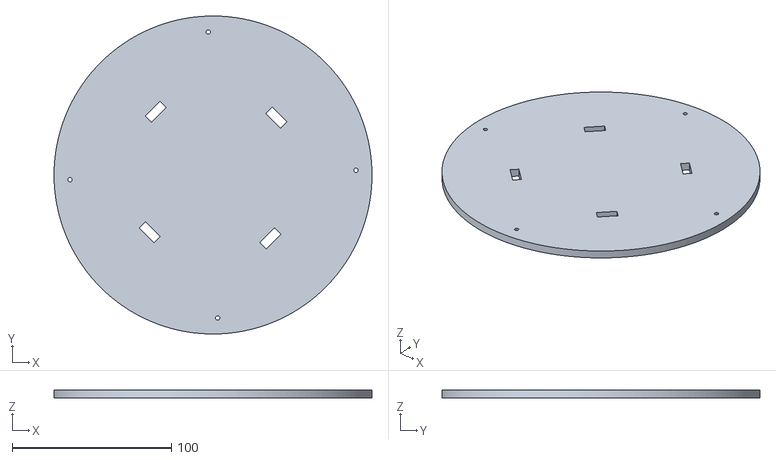
[picture p39: CAD file, 2024-12-04]
prototype/base v5.stl
200.0 x 200.0 x 5.00
