kikifachrizi/Development_Food_Assistant_Robot/prototype/omni-bot/AS_PlasticWheel v5.stl

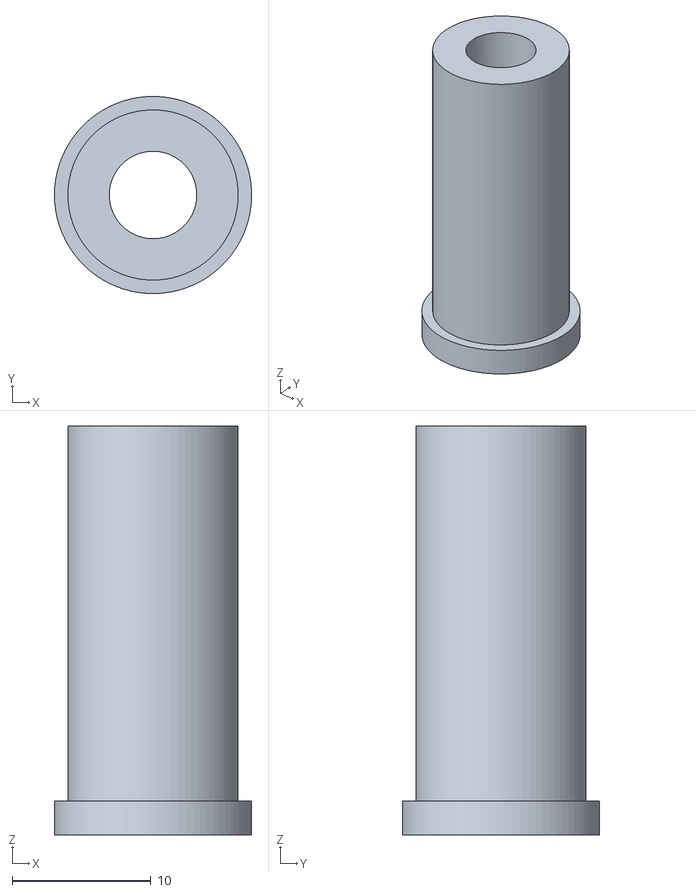
[picture p40: CAD file, 2024-12-04]
prototype/omni-bot/AS_PlasticWheel v5.stl
14.2 x 14.2 x 29.5
