kikifachrizi/Development_Food_Assistant_Robot/prototype/back_mount v1.stl

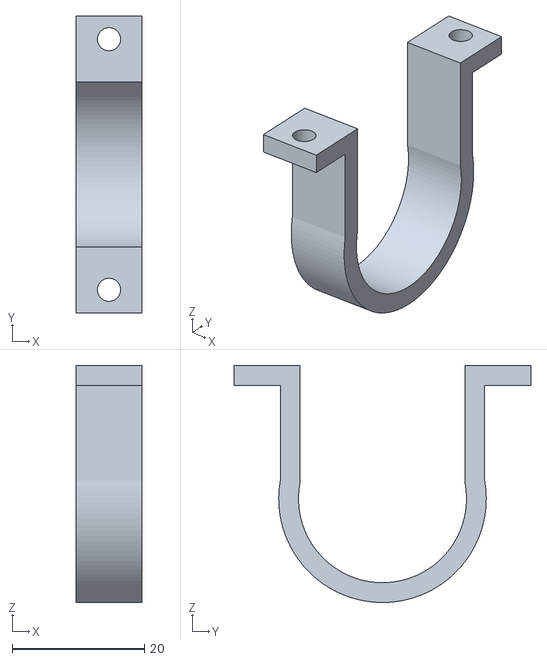
[picture p41: CAD file, 2024-12-04]
prototype/back_mount v1.stl
10.0 x 44.9 x 35.8
