kikifachrizi/Development_Food_Assistant_Robot/prototype/Hinge_ext_enc v5.stl

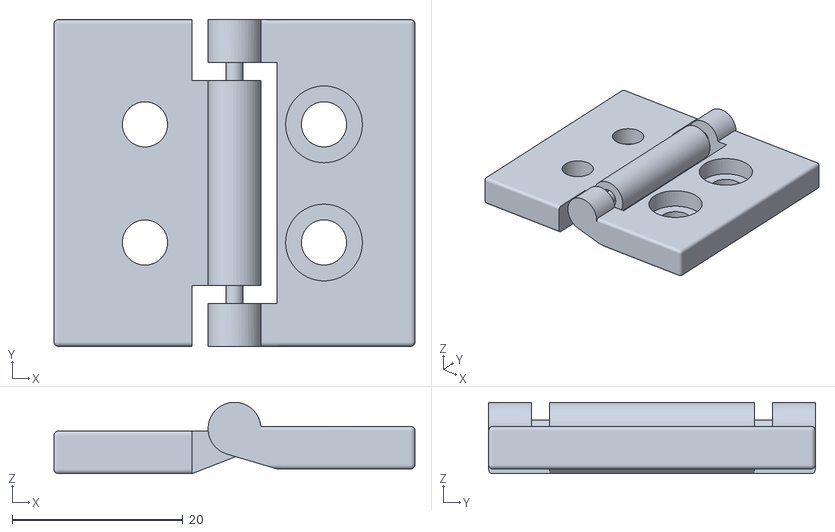
[picture p42: CAD file, 2024-12-04]
prototype/Hinge_ext_enc v5.stl
42.3 x 38.3 x 8.38
