kikifachrizi/Development_Food_Assistant_Robot/(list of files, cad)

Other CAD files:
prototype/omni-bot/base_layer2 v1.stl
prototype/omni-bot/base v9.stl
prototype/base v4.stl
