kikifachrizi/Development_Food_Assistant_Robot/documentation/SISTEM/deli2.kicad_sch

## KiCad design documentation/SISTEM/deli2.kicad_sch (2024-12-04)

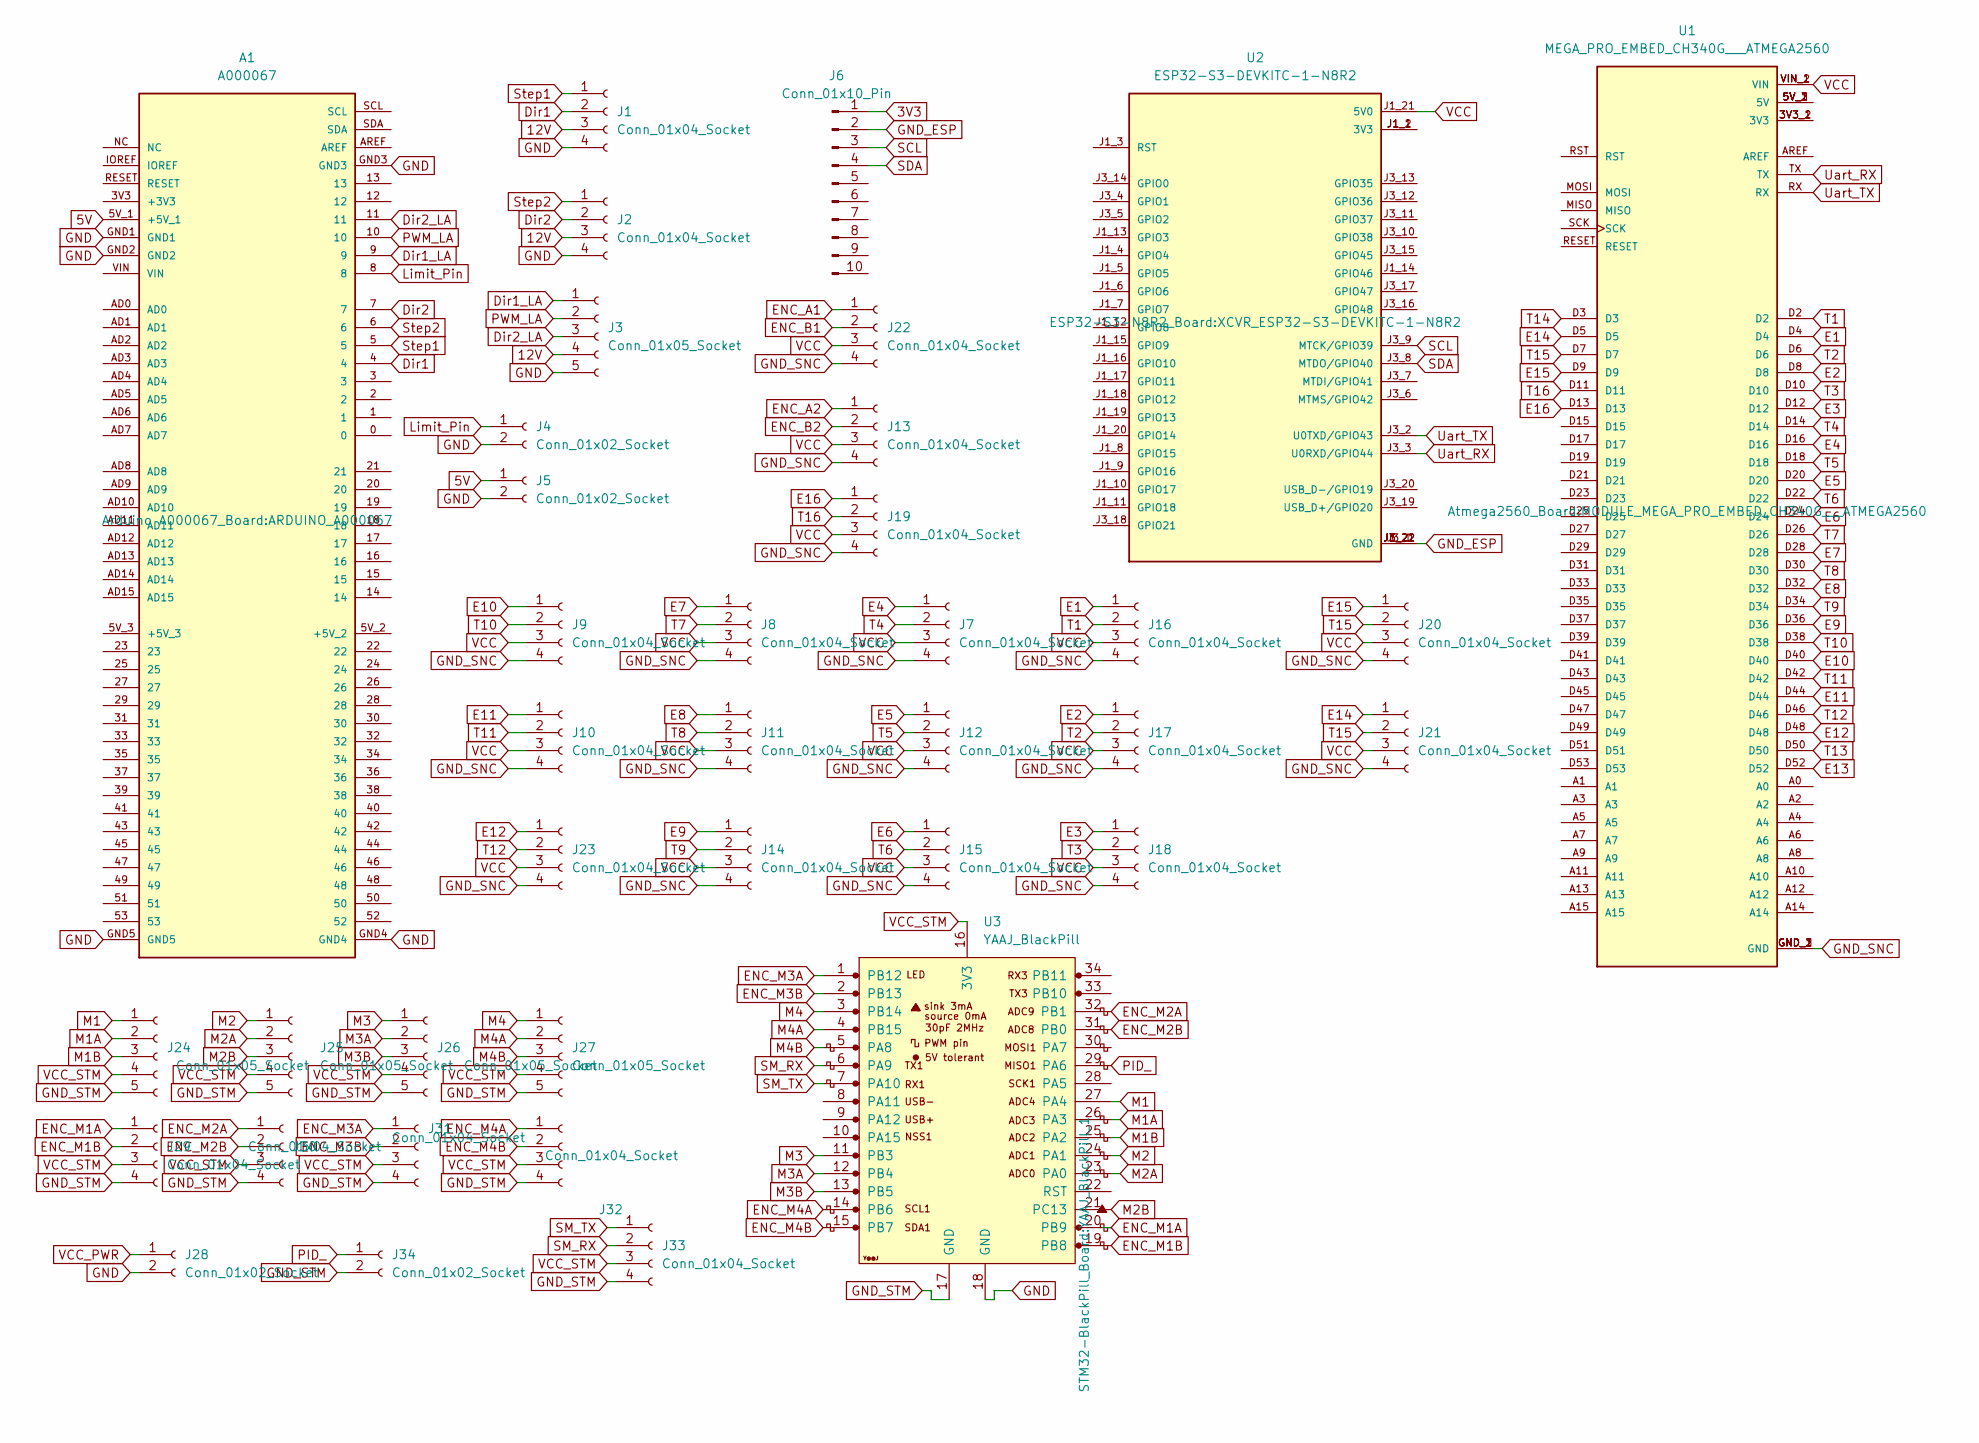
[picture p43: schematic deli2.kicad_sch]

Parts:
A1: A000067; ARDUINO_A000067
J1, J2, J7, J8, J9, J10, J11, J12, J13, J14, J15, J16, J17, J18, J19, J20, J21, J22, J23, J29, J30, J31, J32, J33: Conn_01x04_Socket; JST_XH_B4B-XH-A_1x04_P2.50mm_Vertical
J3, J24, J25, J26, J27: Conn_01x05_Socket; JST_XH_B5B-XH-A_1x05_P2.50mm_Vertical
J4, J5, J28, J34: Conn_01x02_Socket; JST_XH_B2B-XH-A_1x02_P2.50mm_Vertical
J6: Conn_01x10_Pin; PinHeader_1x10_P2.54mm_Vertical
U1: MEGA_PRO_EMBED_CH340G___ATMEGA2560; MODULE_MEGA_PRO_EMBED_CH340G___ATMEGA2560; PARTREV 12/May/2017
U2: ESP32-S3-DEVKITC-1-N8R2; XCVR_ESP32-S3-DEVKITC-1-N8R2; PARTREV V1
U3: YAAJ_BlackPill; YAAJ_BlackPill_1

Connections:
3V3: J6.1
5V: A1.5V_1 (+5V_1), J5.1
12V: J1.3, J2.3, J3.4
Dir1: A1.4, J1.2
Dir1_LA: A1.9, J3.1
Dir2: A1.7, J2.2
Dir2_LA: A1.11, J3.3
E1: J16.1, U1.D4
E2: J17.1, U1.D8
E3: J18.1, U1.D12
E4: J7.1, U1.D16
E5: J12.1, U1.D20
E6: J15.1, U1.D24
E7: J8.1, U1.D28
E8: J11.1, U1.D32
E9: J14.1, U1.D36
E10: J9.1, U1.D40
E11: J10.1, U1.D44
E12: J23.1, U1.D48
E13: U1.D52
E14: J21.1, U1.D5
E15: J20.1, U1.D9
E16: J19.1, U1.D13
ENC_A1: J22.1
ENC_A2: J13.1
ENC_B1: J22.2
ENC_B2: J13.2
ENC_M1A: J29.1, U3.20 (PB9)
ENC_M1B: J29.2, U3.19 (PB8)
ENC_M2A: J30.1, U3.32 (PB1)
ENC_M2B: J30.2, U3.31 (PB0)
ENC_M3A: J31.1, U3.1 (PB12)
ENC_M3B: J31.2, U3.2 (PB13)
ENC_M4A: J32.1, U3.14 (PB6)
ENC_M4B: J32.2, U3.15 (PB7)
GND: A1.GND1, A1.GND2, A1.GND3, A1.GND4, A1.GND5, J1.4, J2.4, J3.5, J4.2, J5.2, J28.2, U3.18 (GND)
GND_ESP: J6.2, U2.J1_22 (GND), U2.J3_1 (GND), U2.J3_21 (GND), U2.J3_22 (GND)
GND_SNC: J7.4, J8.4, J9.4, J10.4, J11.4, J12.4, J13.4, J14.4, J15.4, J16.4, J17.4, J18.4, J19.4, J20.4, J21.4, J22.4, J23.4, U1.GND_1 (GND), U1.GND_2 (GND), U1.GND_3 (GND)
GND_STM: J24.5, J25.5, J26.5, J27.5, J29.4, J30.4, J31.4, J32.4, J33.4, J34.2, U3.17 (GND)
Limit_Pin: A1.8, J4.1
M1: J24.1, U3.27 (PA4)
M1A: J24.2, U3.26 (PA3)
M1B: J24.3, U3.25 (PA2)
M2: J25.1, U3.24 (PA1)
M2A: J25.2, U3.23 (PA0)
M2B: J25.3, U3.21 (PC13)
M3: J26.1, U3.11 (PB3)
M3A: J26.2, U3.12 (PB4)
M3B: J26.3, U3.13 (PB5)
M4: J27.1, U3.3 (PB14)
M4A: J27.2, U3.4 (PB15)
M4B: J27.3, U3.5 (PA8)
unnamed: U1.3V3_1 (3V3), U1.3V3_2 (3V3)
unnamed: U1.5V_1 (5V), U1.5V_2 (5V), U1.5V_3 (5V)
unnamed: U2.J1_1 (3V3), U2.J1_2 (3V3)
PID_: J34.1, U3.29 (PA6)
PWM_LA: A1.10, J3.2
SCL: J6.3, U2.J3_9 (MTCK/GPIO39)
SDA: J6.4, U2.J3_8 (MTDO/GPIO40)
SM_RX: J33.2, U3.6 (PA9)
SM_TX: J33.1, U3.7 (PA10)
Step1: A1.5, J1.1
Step2: A1.6, J2.1
T1: J16.2, U1.D2
T2: J17.2, U1.D6
T3: J18.2, U1.D10
T4: J7.2, U1.D14
T5: J12.2, U1.D18
T6: J15.2, U1.D22
T7: J8.2, U1.D26
T8: J11.2, U1.D30
T9: J14.2, U1.D34
T10: J9.2, U1.D38
T11: J10.2, U1.D42
T12: J23.2, U1.D46
T13: U1.D50
T14: U1.D3
T15: J20.2, J21.2, U1.D7
T16: J19.2, U1.D11
Uart_RX: U1.TX, U2.J3_3 (U0RXD/GPIO44)
Uart_TX: U1.RX, U2.J3_2 (U0TXD/GPIO43)
VCC: J7.3, J8.3, J9.3, J10.3, J11.3, J12.3, J13.3, J14.3, J15.3, J16.3, J17.3, J18.3, J19.3, J20.3, J21.3, J22.3, J23.3, U1.VIN_1 (VIN), U1.VIN_2 (VIN), U2.J1_21 (5V0)
VCC_PWR: J28.1
VCC_STM: J24.4, J25.4, J26.4, J27.4, J29.3, J30.3, J31.3, J32.3, J33.3, U3.16 (3V3)
