kikifachrizi/Development_Food_Assistant_Robot/(commit log)

2024-08-18 push code
    [TA_delivFood_2_map.csv, app_hook.xml, mbed_os-usb_test_device1.cfg, mbed_os-usb_test_device2.cfg, qspi_config.cfg]
2024-12-04 push update
    [AS_PlasticWheel v5.stl, Hinge_ext_enc v5.stl, back_mount v1.stl, base v4.stl, base v5.stl, base v9.stl, base_layer2 v1.stl, deli2.kicad_sch]
